slaterdaniel/SmartSole/Insole CAD parts/CAD/Honeycomb V2.1 (2.5 mm).stl

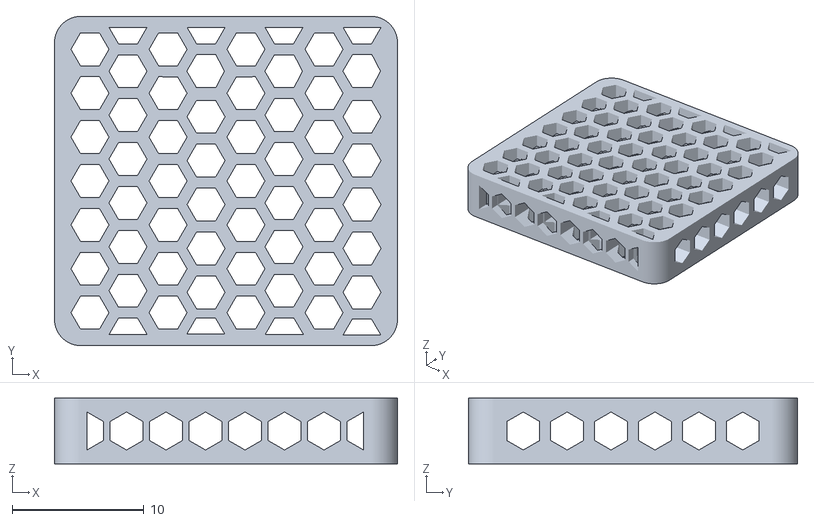
[picture p1: CAD file, 2026-06-16]
Insole CAD parts/CAD/Honeycomb V2.1 (2.5 mm).stl
26.0 x 25.0 x 5.00
