slaterdaniel/SmartSole/Insole CAD parts/Prints/Honeycomb V3.1 (2 mm) .3mf

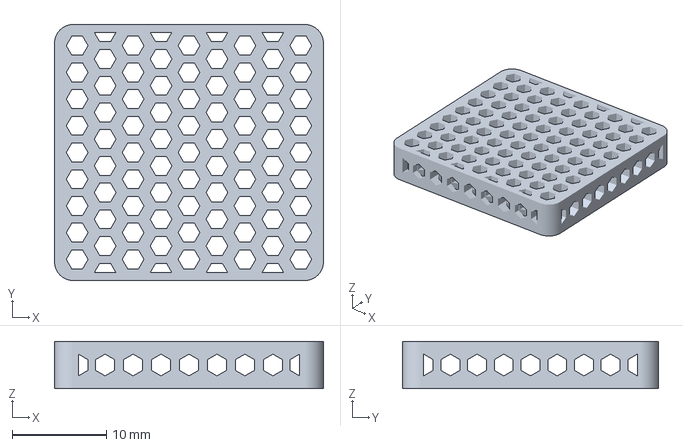
[picture p2: CAD file, 2026-06-16]
Insole CAD parts/Prints/Honeycomb V3.1 (2 mm) .3mf
28.5 x 27.2 x 5.00 mm
