slaterdaniel/SmartSole/Insole CAD parts/CAD/Honeycomb V2 (2.5mm) .stl

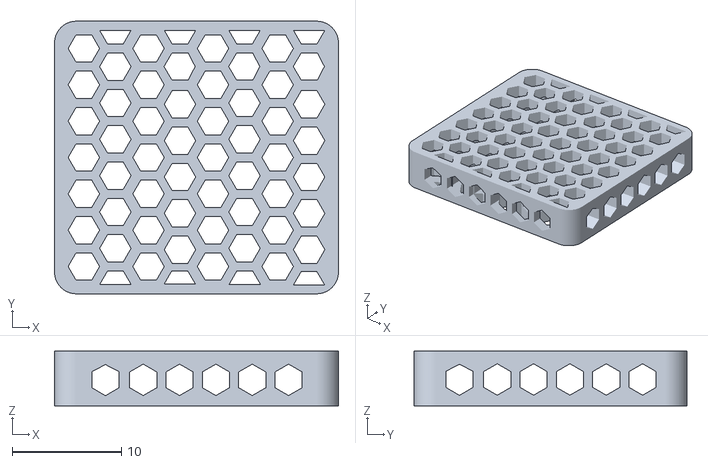
[picture p3: CAD file, 2026-06-12]
Insole CAD parts/CAD/Honeycomb V2 (2.5mm) .stl
26.0 x 25.0 x 5.00
