slaterdaniel/SmartSole/Insole CAD parts/Prints/Honeycomb V3 (2mm).3mf

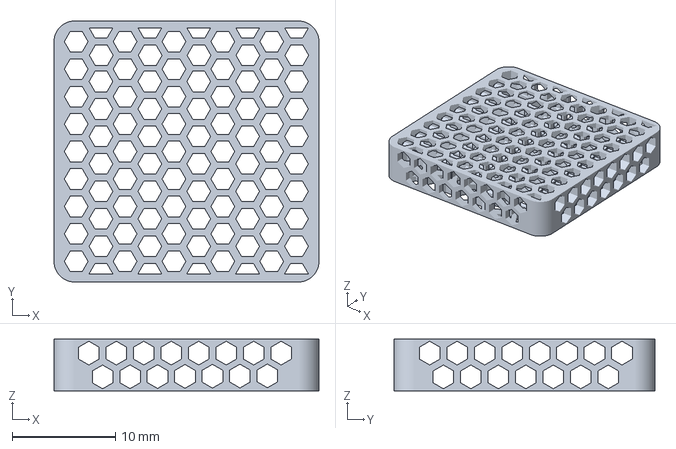
[picture p4: CAD file, 2026-06-12]
Insole CAD parts/Prints/Honeycomb V3 (2mm).3mf
25.7 x 25.3 x 5.00 mm
