slaterdaniel/SmartSole/Insole CAD parts/CAD/Honeycomb V1 (3mm).stl

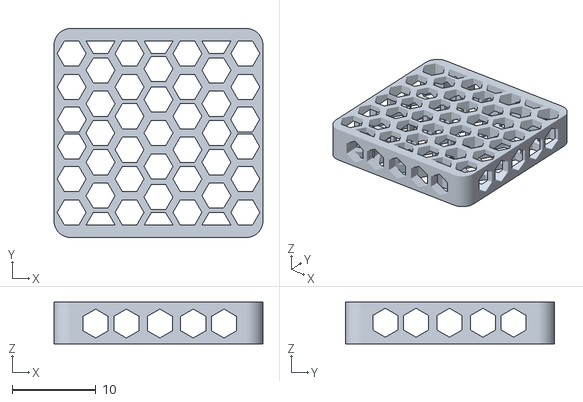
[picture p5: CAD file, 2026-06-11]
Insole CAD parts/CAD/Honeycomb V1 (3mm).stl
25.0 x 25.0 x 5.00
