slaterdaniel/SmartSole/(list of files, cad)

Other CAD files:
Insole CAD parts/Prints/Honeycomb V2 - 2.5mm radius.3mf
Insole CAD parts/Prints/TPU Insole Honeycomb V1.3mf
Insole CAD parts/CAD/Honeycomb V3 (2mm).stl
Insole CAD parts/CAD/Honeycomb V3.1 (2 mm) .stl
