slaterdaniel/SmartSole/smartsole-pcb/smartsole-pcb.kicad_pcb

## KiCad design smartsole-pcb/smartsole-pcb.kicad_pcb (2026-07-16)

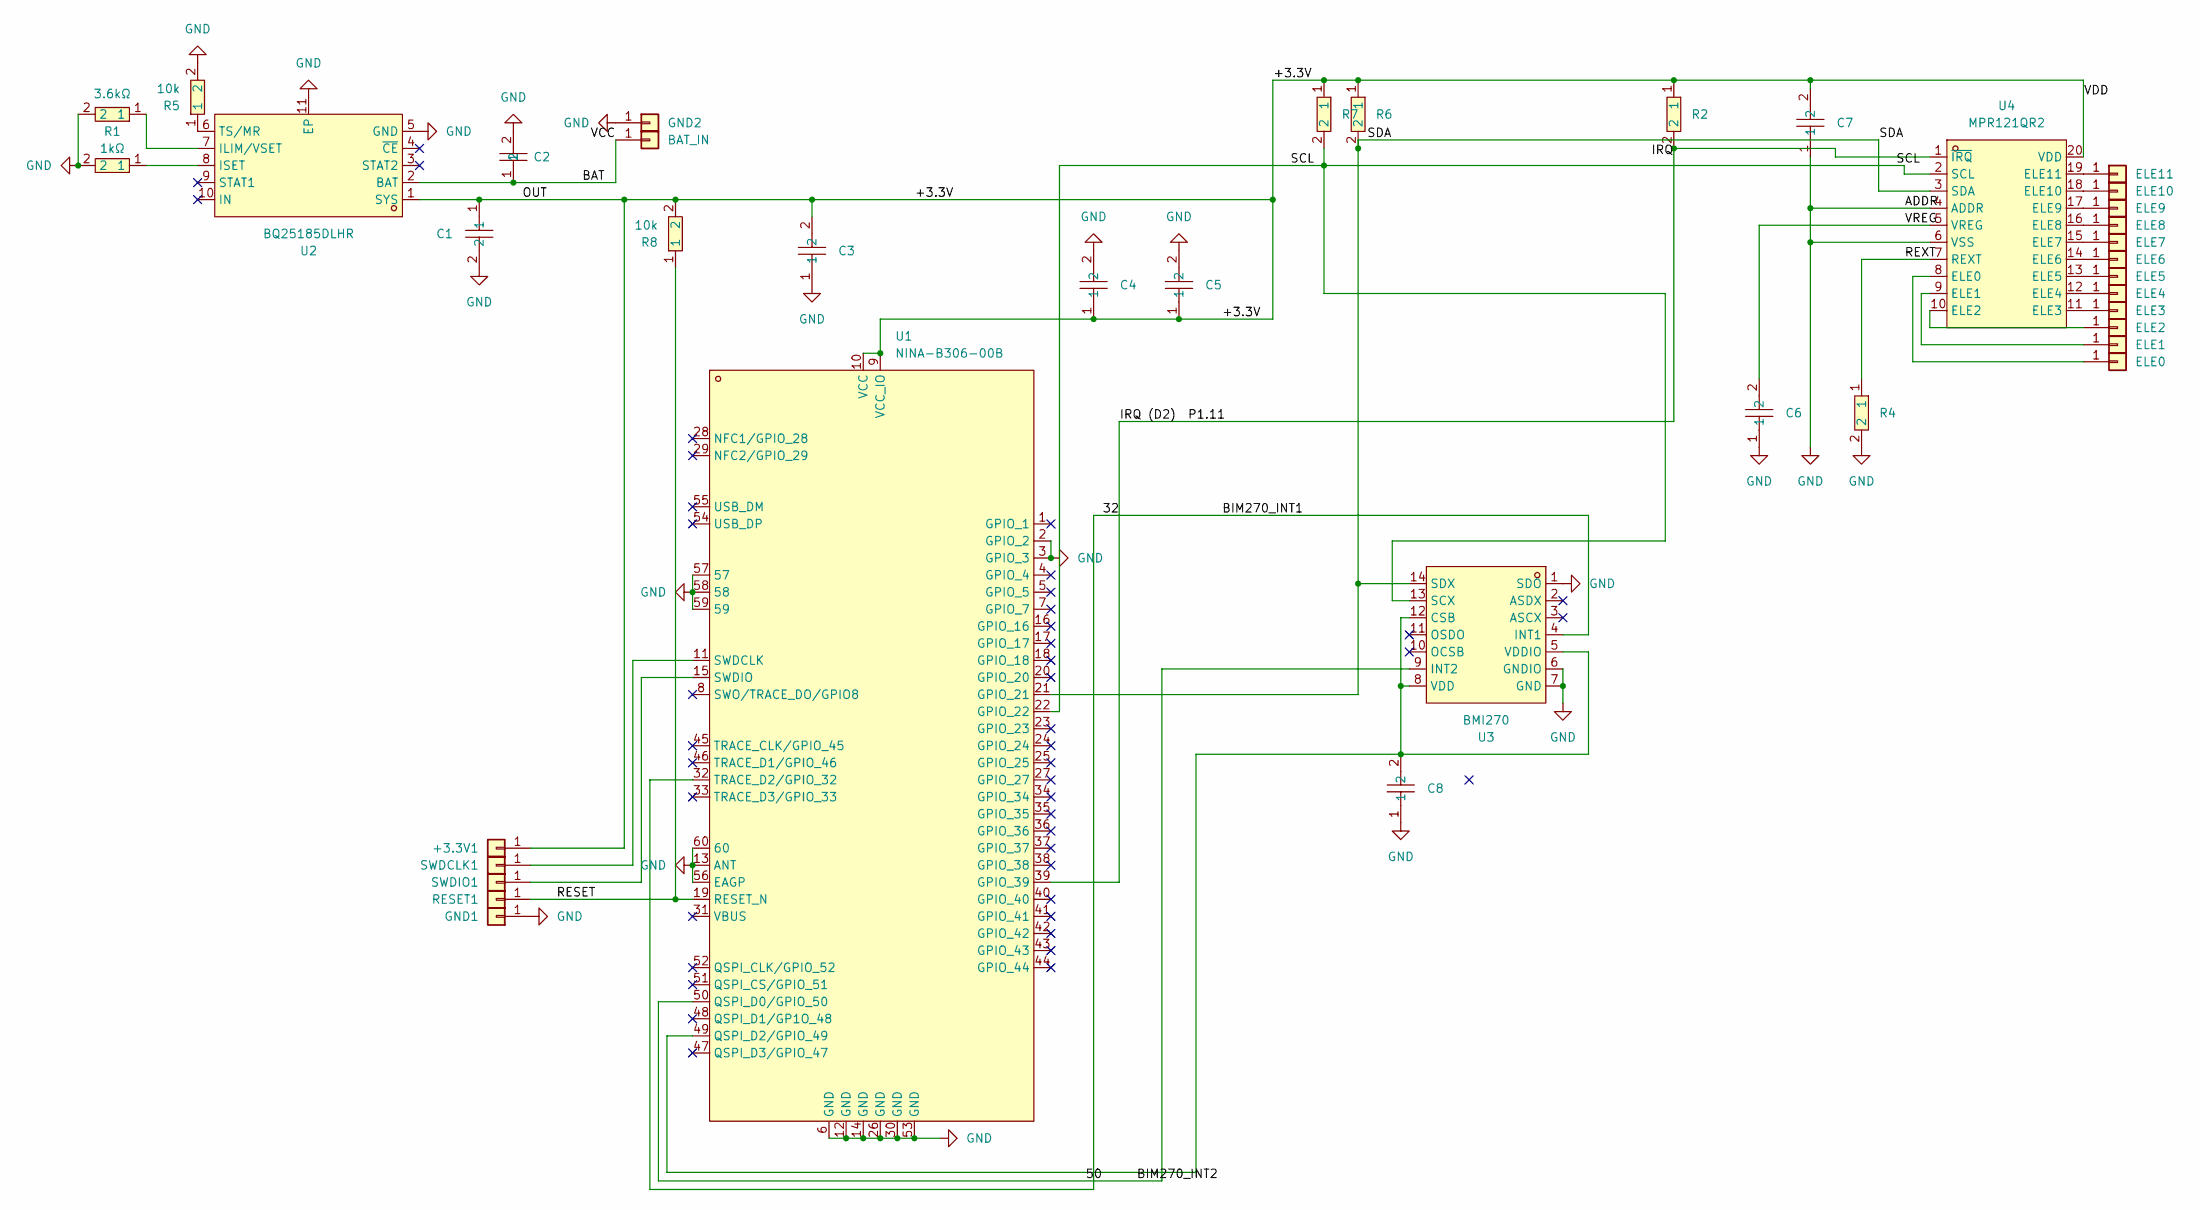
[picture p6: schematic smartsole-pcb.kicad_sch]

Parts:
+3.3V1: Conn_01x01; TestPoint_THTPad_1.0x1.0mm_Drill0.5mm
BAT_IN: Conn_01x01; TestPoint_THTPad_1.0x1.0mm_Drill0.5mm
C1: CL10A106MQ8NNNC; C0603; MPN CL10A106MQ8NNNC; LCSC Part C1691
C2: CL10A105KO8NNNC; C0603; MPN CL10A105KO8NNNC; LCSC Part C1592
C3, C4, C5, C6, C7, C8: CT41G-0805-2X1-50V-0.1μF-M; C0805; MPN CT41G-0805-2X1-50V-0.1uF-M(N); LCSC Part C138340
ELE0, ELE1, ELE2, ELE3, ELE4, ELE5, ELE6, ELE7, ELE8, ELE9, ELE10, ELE11: Conn_01x01; TestPoint_THTPad_1.0x1.0mm_Drill0.5mm
GND1, GND2: Conn_01x01; TestPoint_THTPad_1.0x1.0mm_Drill0.5mm
R1: 3.6kΩ; R0603; MPN 0603WAF3601T5E; LCSC Part C22980
R2, R6, R7: 0805W8F4701T5E; R0805; MPN 0805W8F4701T5E; LCSC Part C17673
R3: 1kΩ; R0603; MPN RC0603JR-071KL; LCSC Part C14676
R4: 0805W8F7502T5E; R0805; MPN 0805W8F7502T5E; LCSC Part C17819
R5, R8: 10k; R0805; MPN 0805W8J0103T5E; LCSC Part C25612
RESET1: Conn_01x01; TestPoint_THTPad_1.0x1.0mm_Drill0.5mm
SWDCLK1: Conn_01x01; TestPoint_THTPad_1.0x1.0mm_Drill0.5mm
SWDIO1: Conn_01x01; TestPoint_THTPad_1.0x1.0mm_Drill0.5mm
U1: NINA-B306-00B; LGA-60_L15.0-W10.0-NINA-B406-00B; MPN NINA-B306-00B; LCSC Part C6127317
U2: BQ25185DLHR; WSON-10_L2.2-W2.0-P0.40-BL-EP_TI_DLH0010A; MPN BQ25185DLHR; LCSC Part C19725033
U3: BMI270; LGA-14_L3.0-W2.5-P0.50-BR; MPN BMI270; LCSC Part C2836813
U4: MPR121QR2; QFN-20_L3.0-W3.0-P0.40-BL; MPN MPR121QR2; LCSC Part C91322

Connections:
/32: U1.32 (TRACE_D2/GPIO_32), U3.4 (INT1)
/50: U1.50 (QSPI_D0/GPIO_50), U3.9 (INT2)
/+3.3V: +3.3V1.1 (Pin_1_1), C1.1, C3.2, C4.1, C5.1, C7.2, R2.1, R6.1, R7.1, R8.2, U1.9 (VCC_IO), U1.10 (VCC), U2.1 (SYS), U4.20 (VDD)
/BAT: BAT_IN.1, C2.1, U2.2 (BAT); also elsewhere on the board
/IRQ: R2.2, U1.39 (GPIO_39), U4.1 (~IRQ)
/RESET: R8.1, RESET1.1 (Pin_1_1), U1.19 (RESET_N)
/REXT: R4.1, U4.7 (REXT)
/SCL: R7.2, U1.22 (GPIO_22), U3.13 (SCX), U4.2 (SCL)
/SDA: R6.2, U1.21 (GPIO_21), U3.14 (SDX), U4.3 (SDA)
/VREG: C6.2, U4.5 (VREG)
GND: C1.2, C2.2, C3.1, C4.2, C5.2, C6.1, C7.1, C8.1, GND1.1 (Pin_1_1), GND2.1 (Pin_1_1), R1.2, R3.2, R4.2, R5.2, U1.2 (GPIO_2), U1.3 (GPIO_3), U1.6 (GND), U1.12 (GND), U1.13 (ANT), U1.14 (GND), U1.26 (GND), U1.30 (GND), U1.53 (GND), U1.56 (EAGP), U1.57, U1.58, U1.59, U1.60, U2.5 (GND), U2.11 (EP), U3.1 (SDO), U3.6 (GNDIO), U3.7 (GND), U4.4 (ADDR), U4.6 (VSS)
unnamed: ELE0.1 (Pin_1_1), U4.8 (ELE0)
unnamed: ELE1.1 (Pin_1_1), U4.9 (ELE1)
unnamed: ELE2.1 (Pin_1_1), U4.10 (ELE2)
unnamed: ELE3.1 (Pin_1_1), U4.11 (ELE3)
unnamed: ELE4.1 (Pin_1_1), U4.12 (ELE4)
unnamed: ELE5.1 (Pin_1_1), U4.13 (ELE5)
unnamed: ELE6.1 (Pin_1_1), U4.14 (ELE6)
unnamed: ELE7.1 (Pin_1_1), U4.15 (ELE7)
unnamed: ELE8.1 (Pin_1_1), U4.16 (ELE8)
unnamed: ELE9.1 (Pin_1_1), U4.17 (ELE9)
unnamed: ELE10.1 (Pin_1_1), U4.18 (ELE10)
unnamed: ELE11.1 (Pin_1_1), U4.19 (ELE11)
unnamed: SWDCLK1.1 (Pin_1_1), U1.11 (SWDCLK)
unnamed: SWDIO1.1 (Pin_1_1), U1.15 (SWDIO)
unnamed: C8.2, U1.49 (QSPI_D2/GPIO_49), U3.5 (VDDIO), U3.8 (VDD), U3.12 (CSB)
unnamed: R1.1, U2.7 (ILIM/VSET)
unnamed: R3.1, U2.8 (ISET)
unnamed: R5.1, U2.6 (TS/MR)

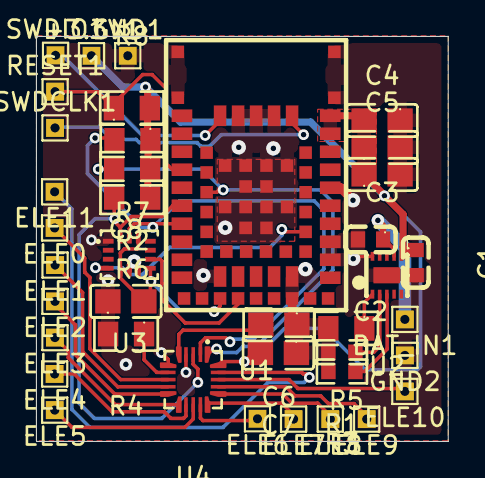
[picture p7: board smartsole-pcb.kicad_pcb from above]

Board: 2 copper layers, 22.9 x 22.5 mm, 39 parts (0 on the bottom side), 29 nets.

Other parts of the board:
BAT_IN1: Conn_01x01; TestPoint_THTPad_1.0x1.0mm_Drill0.5mm

Their connections:
/BAT: BAT_IN1.1 (Pin_1_1); also elsewhere on the board
