slaterdaniel/SmartSole/(commit log)

2026-06-08 created filtered SmartSole Device Scanning and multi device selection
2026-06-09 match device family finder with session settings page
2026-06-09 add AllDeviceScanner to Hompage as a button
2026-06-09 added darkmode/lightmode color scheme capabilities for connected Devices List background
2026-06-09 uniform text coloring for found Device List
2026-06-09 initia commit of arduino .ino files
2026-06-10 establish basic peripheral services and characteristics (data, battery)
2026-06-10 allow for multi device connection
2026-06-11 re structure .ino files for clarity
    [TPU Insole Honeycomb V1.3mf, TPU Insole Honeycomb V1.stl]
2026-06-11 consolidate accelerometer axis values
2026-06-11 gyroscope_test.ino implemented
2026-06-11 added angles calculations to accelerometer test
2026-06-12 setup rep listener framework (without force sensor logic)
2026-06-12 CAD and print Honeycomb V1 - V3
    [Honeycomb V1 (3mm).stl, Honeycomb V2 (2.5mm) .stl, Honeycomb V2 - 2.5mm radius.3mf, Honeycomb V3 (2mm).3mf, Honeycomb V3 (2mm).stl]
2026-06-13 fixed characteristic adding to services
    [insole_code.ino]
2026-06-16 CAD and print Honeycomb test pads V2.1 and V3.1
    [Honeycomb V2.1 (2.5 mm).stl, Honeycomb V3.1 (2 mm) .3mf, Honeycomb V3.1 (2 mm) .stl]
2026-06-16 implement madgwick filter for angles
2026-06-21 drafted 12 electrode force sensor code
2026-06-22 updated force_sensor prototype to account for 12 electrodes
2026-06-22 added python matplotib script for heatmap of force sensing
2026-06-27 add pattern recognition to force sensor testing
2026-06-27 fixed nano testing variable types
    [nano_testing.ino]
2026-06-28 adjust app to match imu output
2026-06-28 access readings through direct i2c registers for speed
2026-06-30 replace hardcoded constants with elements from Constants.h
    [Constants.cpp, insole_code.ino]
2026-07-05 implemented force readings and heatmap representation
2026-07-14 initial commit for pcb farbication kicad files
    [smartsole-V1.1_bom.csv, smartsole-V1.1_designators.csv, smartsole-V1.1_positions.csv, smartsole-V1_bom.csv, smartsole-V1_designators.csv, smartsole-V1_positions.csv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]
2026-07-14 added more ground vias to create faster return paths
    [smartsole-pcb.kicad_pcb]
2026-07-15 began work on V1.3 - antenna moved to board edge, better GND plane, and better decoupling capacitor placement
    [smartsole-V1.1_bom.csv, smartsole-V1.1_designators.csv, smartsole-V1.1_positions.csv, smartsole-V1_bom.csv, smartsole-V1_designators.csv, smartsole-V1_positions.csv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]
2026-07-15 V1.3 - slightly smaller
    [smartsole-V1_bom.csv, smartsole-V1_designators.csv, smartsole-V1_positions.csv, smartsole-pcb-BOM.csv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]
2026-07-16 smartsole-V1.3 FINAL
    [3units-digikey-BOM.csv, smartsole-pcb.kicad_pcb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]
2026-08-07 get rid of uneeded Arduino library for bmi270 and bmi150
